Rayan-01/dwm-robot/docs/architecture.md

# Software architecture

## Package responsibilities

| Package | Responsibility |
| --- | --- |
| `dwm_core` | Controller state, motion geometry, wheel/gyro odometry and writable paths |
| `dwm_perception` | OAK acquisition, dark-grass candidates, detector assets and YOLO tools |
| `dwm_robot` | HTTP dashboard, detector worker, Arduino telemetry and sole motor writer |
| `dwm_navigation` | ROS TF/odometry, map persistence, localization checks and waypoint goals |
| `dwm_bringup` | Application/lidar launch, SLAM/Nav2 sessions and default configuration |

```mermaid
flowchart LR
    Camera[OAK-D Pro] --> Vision[Detection and aligned depth]
    Vision --> Server[Robot server :8080]
    Browser[Web dashboard] --> Server
    Server <--> Arduino[Arduino motor controller]
    Arduino --> Drive[Tracks and brush]
    Lidar[RPLidar S2] --> Scan["/scan"]
    Scan --> Bridge[Navigation bridge :8091]
    Server --> Bridge
    Bridge --> Odom["/odometry/filtered and TF"]
    Odom --> Nav[SLAM Toolbox or AMCL + Nav2]
    Scan --> Nav
    Nav --> Smooth[Velocity smoother]
    Smooth --> Collision[Collision monitor]
    Collision --> Bridge
    Bridge --> Server
```

## Motor ownership

The robot server is the only Arduino serial writer. Navigation requests a bounded
motor session through its localhost HTTP interface. The bridge sends command
velocities with sequence numbers and live lidar points. Direct ROS velocity
publishing does not open Arduino or bypass the server's command checks.

The browser owns a short-lived control lease and sends heartbeats. The ROS
bridge does not keep that browser lease alive independently. Page visibility,
communication age and explicit Stop affect motion in both manual and route modes.

## ROS interfaces

| Interface | Type / direction |
| --- | --- |
| `/scan` | `sensor_msgs/LaserScan`, lidar to navigation |
| `/odometry/filtered` | `nav_msgs/Odometry`, bridge to Nav2/SLAM |
| `/tf` | `odom -> base_footprint`, bridge |
| `/tf_static` | `base_footprint -> laser`, bridge |
| `/map` | `nav_msgs/OccupancyGrid`, SLAM or map server |
| `/initialpose` | `geometry_msgs/PoseWithCovarianceStamped`, bridge to AMCL |
| `/plan` | `nav_msgs/Path`, Nav2 to map display |
| `/cmd_vel_nav` | `geometry_msgs/Twist`, controller/behaviors to smoother |
| `/cmd_vel` | `geometry_msgs/Twist`, smoother to collision monitor |
| `/cmd_vel_safe` | `geometry_msgs/Twist`, collision monitor to bridge |
| `/navigate_to_pose` | `nav2_msgs/action/NavigateToPose`, bridge to Nav2 |

The ROS topic name `/odometry/filtered` refers to the custom planar gyro/wheel
filter implemented in `dwm_core.navigation_core`.

## Navigation and motion tuning

NavFn uses A* with unknown space excluded. DWB is the local controller; it scores
trajectories using the complete robot footprint. Costmap padding and the direct
swept-body guard use a 3 cm buffer. The collision monitor follows velocity
smoothing in the command chain so a blocked command is not subsequently ramped.

Maximum navigation speed is 0.12 m/s and 0.30 rad/s. Linear acceleration is
0.08 m/s² and normal deceleration is 0.16 m/s². Angular acceleration is
0.22 rad/s² and normal deceleration is 0.30 rad/s². Emergency/stale-command stops
are separate from normal smoothing. DWB samples 20 linear and 41 angular values.

## Map sessions and persistence

The bridge starts one owned SLAM or Nav2 launch process group at a time. The web
page starts and stops sessions; the top-level application launch does not also
start SLAM or Nav2. Named maps use `<name>/map.yaml` and an image. Route drafts
are JSON, bound to their map name and executed in order.

Runtime files live under `DWM_DATA_DIR`, default `~/.local/share/dwm_robot`.
Installed assets, weights and web files are resolved through ament package shares.
This keeps editable settings and map writes out of the installation tree.

## Implementation provenance

Control workers, serial integration, browser control, geometry checks and
waypoint coordination are project code. ROS 2, Nav2, SLAM Toolbox, DepthAI and
Ultralytics are upstream dependencies. NavFn A*, DWB and BoT-SORT are configured
components, not algorithms reimplemented in this repository.

The repository uses a colcon workspace to separate the robot application into
control, perception, hardware, navigation and bringup packages. Launch files
coordinate sensor and navigation processes; the map-storage module persists
named occupancy maps in Nav2 YAML/PGM format. Writable settings and mission data
remain separate from installed package resources.

## References

- [ROS 2 Jazzy](https://docs.ros.org/en/jazzy/)
- [Nav2 configuration](https://docs.nav2.org/jazzy/configuration_and_development/)
- [SLAM Toolbox](https://github.com/SteveMacenski/slam_toolbox)
- [RPLidar ROS driver](https://github.com/Slamtec/rplidar_ros)
- [Ultralytics](https://docs.ultralytics.com/)
