Rayan-01/dwm-robot/src/dwm_perception/training/yolo26n_poop/results.csv

epoch | time | train/box_loss | train/cls_loss | train/l1_loss | metrics/precision(B) | metrics/recall(B) | metrics/mAP50(B) | metrics/mAP50-95(B) | val/box_loss | val/cls_loss | val/l1_loss | lr/pg0 | lr/pg1 | lr/pg2
1 | 63.927 | 1.36697 | 8.32204 | 0.00257 | 0.00291 | 0.91608 | 0.03917 | 0.03144 | 0.84557 | 8.5276 | 0.00239 | 0.000654088 | 0.000654088 | 0.000654088
2 | 94.7572 | 1.19393 | 4.98286 | 0.00216 | 0.89617 | 0.66391 | 0.79975 | 0.60789 | 0.94522 | 5.45381 | 0.00263 | 0.00131204 | 0.00131204 | 0.00131204
3 | 127.276 | 1.20065 | 3.48457 | 0.00215 | 0.68562 | 0.67832 | 0.70659 | 0.55952 | 1.1364 | 3.61687 | 0.00343 | 0.00196119 | 0.00196119 | 0.00196119
4 | 158.908 | 1.11217 | 2.55183 | 0.00198 | 0.71547 | 0.68581 | 0.74804 | 0.563 | 1.25363 | 2.68279 | 0.00401 | 0.0019604 | 0.0019604 | 0.0019604
5 | 190.886 | 1.07294 | 1.79072 | 0.00194 | 0.72979 | 0.71773 | 0.75525 | 0.58165 | 1.00512 | 1.88341 | 0.00308 | 0.0019472 | 0.0019472 | 0.0019472
6 | 224.349 | 1.10687 | 1.40179 | 0.00194 | 0.7566 | 0.73907 | 0.78745 | 0.59041 | 1.08587 | 1.55581 | 0.00344 | 0.001934 | 0.001934 | 0.001934
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
