Rayan-01/dwm-robot/src/dwm_bringup/config/navigation_params.yaml

amcl:
  ros__parameters:
    use_sim_time: false
    alpha1: 0.2
    alpha2: 0.2
    alpha3: 0.2
    alpha4: 0.2
    alpha5: 0.2
    base_frame_id: base_footprint
    beam_skip_distance: 0.5
    beam_skip_error_threshold: 0.9
    beam_skip_threshold: 0.3
    do_beamskip: false
    global_frame_id: map
    lambda_short: 0.1
    laser_likelihood_max_dist: 2.0
    laser_max_range: 12.0
    laser_min_range: -1.0
    laser_model_type: likelihood_field
    max_beams: 60
    max_particles: 2000
    min_particles: 500
    odom_frame_id: odom
    pf_err: 0.05
    pf_z: 0.99
    recovery_alpha_fast: 0.0
    recovery_alpha_slow: 0.0
    resample_interval: 1
    robot_model_type: nav2_amcl::DifferentialMotionModel
    save_pose_rate: 0.5
    sigma_hit: 0.2
    tf_broadcast: true
    transform_tolerance: 1.0
    update_min_a: 0.1
    update_min_d: 0.1
    z_hit: 0.5
    z_max: 0.05
    z_rand: 0.5
    z_short: 0.05
    scan_topic: scan
bt_navigator:
  ros__parameters:
    use_sim_time: false
    global_frame: map
    robot_base_frame: base_footprint
    odom_topic: /odometry/filtered
    bt_loop_duration: 10
    default_server_timeout: 1000
    wait_for_service_timeout: 1000
    navigators:
    - navigate_to_pose
    - navigate_through_poses
    navigate_to_pose:
      plugin: nav2_bt_navigator::NavigateToPoseNavigator
    navigate_through_poses:
      plugin: nav2_bt_navigator::NavigateThroughPosesNavigator
    error_code_names:
    - compute_path_error_code
    - follow_path_error_code
controller_server:
  ros__parameters:
    use_sim_time: false
    controller_frequency: 10.0
    min_x_velocity_threshold: 0.001
    min_y_velocity_threshold: 0.001
    min_theta_velocity_threshold: 0.001
    failure_tolerance: 0.3
    goal_checker_plugins:
    - general_goal_checker
    controller_plugins:
    - FollowPath
    progress_checker:
      plugin: nav2_controller::SimpleProgressChecker
      required_movement_radius: 0.15
      movement_time_allowance: 20.0
    general_goal_checker:
      stateful: true
      plugin: nav2_controller::SimpleGoalChecker
      xy_goal_tolerance: 0.12
      yaw_goal_tolerance: 0.25
    FollowPath:
      plugin: dwb_core::DWBLocalPlanner
      debug_trajectory_details: false
      min_vel_x: 0.0
      min_vel_y: 0.0
      max_vel_x: 0.12
      max_vel_y: 0.0
      max_vel_theta: 0.3
      min_speed_xy: 0.0
      max_speed_xy: 0.12
      min_speed_theta: 0.0
      acc_lim_x: 0.08
      acc_lim_y: 0.0
      acc_lim_theta: 0.22
      decel_lim_x: -0.16
      decel_lim_y: 0.0
      decel_lim_theta: -0.3
      vx_samples: 20
      vy_samples: 1
      vtheta_samples: 41
      sim_time: 2.0
      linear_granularity: 0.05
      angular_granularity: 0.025
      transform_tolerance: 0.2
      xy_goal_tolerance: 0.25
      trans_stopped_velocity: 0.03
      short_circuit_trajectory_evaluation: true
      stateful: true
      critics:
      - RotateToGoal
      - Oscillation
      - ObstacleFootprint
      - GoalAlign
      - PathAlign
      - PathDist
      - GoalDist
      PathAlign.scale: 32.0
      PathAlign.forward_point_distance: 0.1
      GoalAlign.scale: 24.0
      GoalAlign.forward_point_distance: 0.1
      PathDist.scale: 32.0
      GoalDist.scale: 24.0
      RotateToGoal.scale: 32.0
      RotateToGoal.slowing_factor: 5.0
      RotateToGoal.lookahead_time: -1.0
      ObstacleFootprint.scale: 1.0
    odom_topic: /odometry/filtered
    progress_checker_plugins:
    - progress_checker
    enable_stamped_cmd_vel: false
local_costmap:
  local_costmap:
    ros__parameters:
      update_frequency: 5.0
      publish_frequency: 2.0
      global_frame: odom
      robot_base_frame: base_footprint
      use_sim_time: false
      rolling_window: true
      width: 4
      height: 4
      resolution: 0.05
      plugins:
      - obstacle_layer
      - inflation_layer
      inflation_layer:
        plugin: nav2_costmap_2d::InflationLayer
        cost_scaling_factor: 3.0
        inflation_radius: 0.8
      static_layer:
        plugin: nav2_costmap_2d::StaticLayer
        map_subscribe_transient_local: true
      always_send_full_costmap: true
      footprint: '[[0.26035, 0.254], [0.26035, -0.254], [-0.65405, -0.254], [-0.65405,
        0.254]]'
      footprint_padding: 0.03
      obstacle_layer:
        plugin: nav2_costmap_2d::ObstacleLayer
        enabled: true
        max_obstacle_height: 2.0
        observation_sources: scan
        scan:
          topic: /scan
          max_obstacle_height: 2.0
          clearing: true
          marking: true
          data_type: LaserScan
          raytrace_max_range: 6.0
          raytrace_min_range: 0.0
          obstacle_max_range: 5.0
          obstacle_min_range: 0.0
global_costmap:
  global_costmap:
    ros__parameters:
      update_frequency: 1.0
      publish_frequency: 1.0
      global_frame: map
      robot_base_frame: base_footprint
      use_sim_time: false
      resolution: 0.05
      track_unknown_space: true
      plugins:
      - static_layer
      - obstacle_layer
      - inflation_layer
      obstacle_layer:
        plugin: nav2_costmap_2d::ObstacleLayer
        enabled: true
        observation_sources: scan
        scan:
          topic: /scan
          max_obstacle_height: 2.0
          clearing: true
          marking: true
          data_type: LaserScan
          raytrace_max_range: 6.0
          raytrace_min_range: 0.0
          obstacle_max_range: 5.0
          obstacle_min_range: 0.0
      static_layer:
        plugin: nav2_costmap_2d::StaticLayer
        map_subscribe_transient_local: true
      inflation_layer:
        plugin: nav2_costmap_2d::InflationLayer
        cost_scaling_factor: 3.0
        inflation_radius: 0.8
      always_send_full_costmap: true
      footprint: '[[0.26035, 0.254], [0.26035, -0.254], [-0.65405, -0.254], [-0.65405,
        0.254]]'
      footprint_padding: 0.03
map_server:
  ros__parameters:
    use_sim_time: false
    yaml_filename: ''
map_saver:
  ros__parameters:
    use_sim_time: false
    save_map_timeout: 5.0
    free_thresh_default: 0.25
    occupied_thresh_default: 0.65
    map_subscribe_transient_local: true
planner_server:
  ros__parameters:
    expected_planner_frequency: 1.0
    use_sim_time: false
    planner_plugins:
    - GridBased
    GridBased:
      plugin: nav2_navfn_planner::NavfnPlanner
      tolerance: 0.15
      use_astar: true
      allow_unknown: false
smoother_server:
  ros__parameters:
    use_sim_time: false
    smoother_plugins:
    - simple_smoother
    simple_smoother:
      plugin: nav2_smoother::SimpleSmoother
      tolerance: 1.0e-10
      max_its: 1000
      do_refinement: true
behavior_server:
  ros__parameters:
    cycle_frequency: 10.0
    behavior_plugins:
    - spin
    - backup
    - drive_on_heading
    - assisted_teleop
    - wait
    spin:
      plugin: nav2_behaviors::Spin
    backup:
      plugin: nav2_behaviors::BackUp
    drive_on_heading:
      plugin: nav2_behaviors::DriveOnHeading
    wait:
      plugin: nav2_behaviors::Wait
    assisted_teleop:
      plugin: nav2_behaviors::AssistedTeleop
    global_frame: map
    robot_base_frame: base_footprint
    transform_tolerance: 0.1
    use_sim_time: false
    simulate_ahead_time: 2.0
    max_rotational_vel: 0.4
    min_rotational_vel: 0.1
    rotational_acc_lim: 0.5
    local_costmap_topic: local_costmap/costmap_raw
    local_footprint_topic: local_costmap/published_footprint
    global_costmap_topic: global_costmap/costmap_raw
    global_footprint_topic: global_costmap/published_footprint
    local_frame: odom
    enable_stamped_cmd_vel: false
robot_state_publisher:
  ros__parameters:
    use_sim_time: false
waypoint_follower:
  ros__parameters:
    use_sim_time: false
    loop_rate: 20
    stop_on_failure: true
    waypoint_task_executor_plugin: wait_at_waypoint
    wait_at_waypoint:
      plugin: nav2_waypoint_follower::WaitAtWaypoint
      enabled: true
      waypoint_pause_duration: 200
velocity_smoother:
  ros__parameters:
    use_sim_time: false
    smoothing_frequency: 20.0
    scale_velocities: true
    feedback: OPEN_LOOP
    max_velocity:
    - 0.12
    - 0.0
    - 0.3
    min_velocity:
    - -0.12
    - 0.0
    - -0.3
    max_accel:
    - 0.08
    - 0.0
    - 0.22
    max_decel:
    - -0.16
    - 0.0
    - -0.3
    odom_topic: /odometry/filtered
    odom_duration: 0.1
    deadband_velocity:
    - 0.0
    - 0.0
    - 0.0
    velocity_timeout: 0.3
    enable_stamped_cmd_vel: false
collision_monitor:
  ros__parameters:
    base_frame_id: base_footprint
    odom_frame_id: odom
    cmd_vel_in_topic: cmd_vel
    cmd_vel_out_topic: cmd_vel_safe
    transform_tolerance: 0.2
    source_timeout: 0.5
    stop_pub_timeout: 1.0
    enable_stamped_cmd_vel: false
    polygons:
    - BodyStop
    BodyStop:
      type: polygon
      points: '[[0.29035, 0.284], [0.29035, -0.284], [-0.68405, -0.284], [-0.68405,
        0.284]]'
      action_type: stop
      min_points: 3
      visualize: true
      polygon_pub_topic: body_stop
    observation_sources:
    - scan
    scan:
      type: scan
      topic: /scan
      enabled: true
